littlewire/Little-Wire/Readme.md

# Little Wire

For more details: <http://littlewire.github.io>

Current version is: **v1.3**

Previous version releases can be found at: <https://github.com/littlewire/Little-Wire/releases>
