littlewire/Little-Wire/hardware/Readme.md

#Little Wire Hardware Files

##Schematic

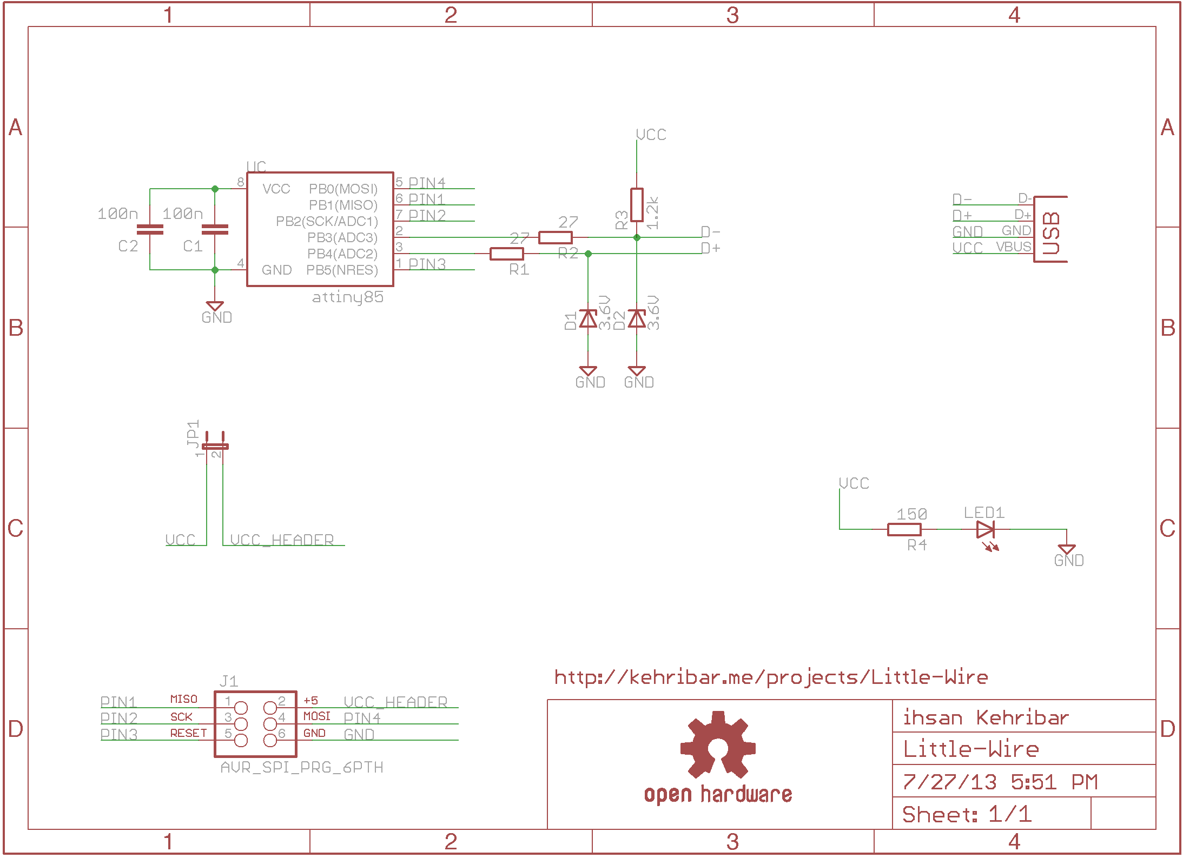
[picture p1: hardware/Little-Wire_sch.png]
sch


##Layout

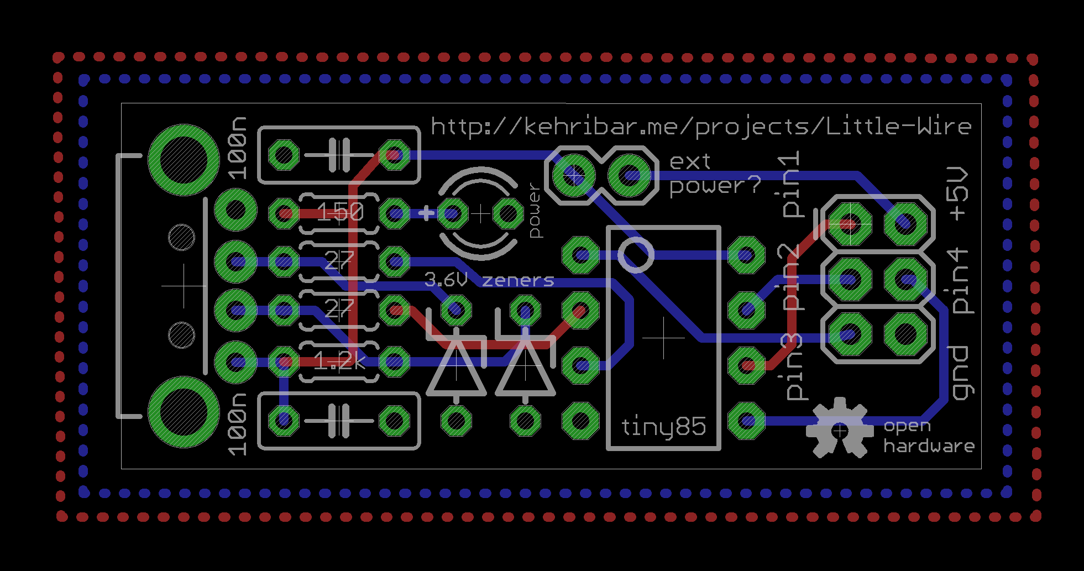
[picture p2: hardware/Little-Wire_brd.png]
brd


##Note

I didn't had the littlewire.github.io domain/website when I produced/designed this board, therefore schematic and board files are signed with my personal webpage which now redirects to the littlewire.github.io

##Licence

This project is © ihsan Kehribar, and is published under the terms of the GNU General Public License, version 3 licence.
