littlewire/Little-Wire/lw.jpg

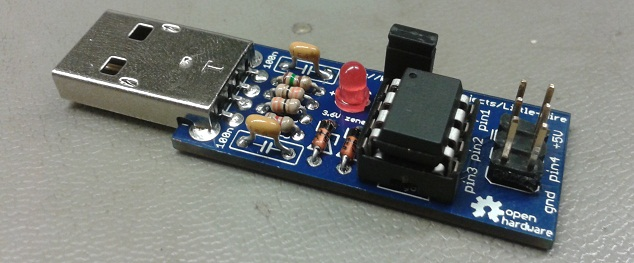
lw.jpg
