littlewire/Little-Wire/(commit log)

2011-11-05 adc example added
2011-12-03 windows driver added ...
2011-12-24 Added a blink example and fixed the adc one (Accidentally removed newline).
    [blink.c]
2011-12-25 Changed littleWire_connect() to return NULL instead of printing an error message, since libraries should not interact with the user really.
    Also updated the examples to reflect this change.
    [adc.c, blink.c]
2011-12-25 New example: Read a button state using threads. (Not fully tested!)
2011-12-25 Added pin definitions and tidied up a little bit. Also added an include guard for the library.
2011-12-25 Updated examples to match new library structure. Also simplified the button example significantly :)
2011-12-25 Button listener, using threads (Experimental!)
2011-12-26 Higher level servo library added.
2011-12-26 Servo example added.
2011-12-26 Added a few aliases, namely the ADC ones.
2011-12-26 Replaced delay_ms stuff with the new utility lib.
    [adc.c, blink.c, button.c, button_thread.c, servo.c]
2011-12-27 Servo library and example fixed.
    [servo.c]
2011-12-27 i2c_requestFrom function added to firmware.
2011-12-27 SPI delay setting included.
2011-12-27 Added i2c support to C library.
2011-12-29 i2c - blinkM example added.
2011-12-29 i2c blinkM fixed.
2011-12-31 Spi example added.
2011-12-31 Spi example fix
2012-01-29 modified: Little-Wire_beta.jpg
2012-01-29 C servo library fix
2012-04-02 Arduino interface library added!
2012-04-06 Update on arduino library.
2012-06-12 Initial commit for led_demo
2012-06-12 Initial commit for pwm_demo
2012-06-17 Added disclaimer about USB VID/PID
2012-06-17 Added disclaimer on USB VID/PID
2012-08-25 New lwbuttond example
    This example is a unix daemon. It configures the lw device as input to read connected buttons and executes a command is a button is pressed.
    The actual daemon is fairly robust (survives disconnect(reconnect of the lw device)
2012-08-26 Improved syslog messages
    Added messages to syslog on device reconnect.
2012-09-19 Experimental 64 bit drivers has been added.
2013-02-12 Update v1.1/computer_interface/C/examples/onewire.c
    print human-friendly temperature
2013-03-15 [onewire] increased the delay value for conversion
    - If the DS18B20 is having output od 85 deg. C this change helps
    - tested with two separate devices on two separate systems with a same result
2013-03-15 [onewire] more devel friendly
    - added more debug messages
    - added a few debug hints for newbies
    - added code to print temperature with higher resolution
2013-03-15 [onewire] more novice info
    - added info on how to connect the DS18B20 sensor to LittleWire
2013-05-26 Initial commit for WS2812 support
    Support for WS2812 programmes RGB LEDs and LED-strings.
2013-05-27 ws2812 support: added flush function
    Added ws2812_flush function to write the internal buffer to the led
    string without having to pass another rgb value. This simplifies the
    programmer interface.
2013-05-27 ws2812 support: added two examples
    fade_ws2812: Adapted from Softpwm fade
    rgb_cycle_w2812: cycles an led string using the internal buffer.
2013-06-18 Updated for the multiple device support.
2013-07-27 hardware files are added.
    [Little-Wire.brd, Little-Wire.sch]
2013-07-29 Pin Mapping is added.
2013-09-14 Modified I2C driver.
2013-09-14 Fix i2c read bug in the read function by adding a small delay.
2013-11-17 Changed the default LED position
