littlewire/Little-Wire/(notices)

Notices in the files:
firmware/main.c:
modify it under the terms of the GNU General Public License
